wooyeolj/Vision-Based-ADAS/docs/2024년 한이음 ICT멘토링 프로젝트 결과보고서-(일부 내용 편집).pdf

- 1 -

# 2024년 한이음 ICT멘토링

# 프로젝트 결과보고서

프로젝트명 | Development of Vision-Based Intelligent Driving Lane Recognition and Forward Vehicle Collision Avoidance Technology
- 2 -

## 요 약 본

프로젝트 정보

프로젝트명 | 비전 기반 지능형 주행 차선 인식 및 전방 차량 충돌 회피 기술 개발
주제 영역 | □ 생활 □ 업무 ☑ 공공/교통 □ 금융/핀테크 □ 의료 □ 교육 □ 유통/쇼핑 □ 엔터테인먼트
기술 분야 | ☑ SW·AI □ 방송·콘텐츠 □ 블록체인·융합 □ 디바이스 □ 차세대보안 □ 미래통신·전파
달성 성과 | □ 논문게재 및 포스터 발표 □ 앱등록 □ 프로그램등록 □ 특허 □ 기술이전 □ 실용화 □ 공모전( ) ☑ 기타( 프로젝트 완성 )
프로젝트 소개 | 기존 ADAS는 차선이탈 경보, 추돌경보, 교통신호 알람, 보행자 인식 등의 다양한 기능을 여러 센서와 카메라를 이용하여 구현 중이다. 해당 프로젝트에서는 센서를 사용하지 않고, 비전 기반의 여러 영상 처리 기법을 통해, ADAS 기술을 발전시킨다.
개발 배경 및 필요성 | ADAS 기술은 운전자의 안전과 편의성 측면에서 중요한 요소로 부상하고 있다. 날씨 정보를 고려하며, 더욱 지능화된 비전 기반 ADAS 기술은, 운전자의 안전뿐만 아니라 자율주행 기술의 발달, 사회 전반적으로 경제적인 이익을 가져와 줄 것이다.
프로젝트 특·장점 | ・주행차선인식: Canny Edge Detection 알고리즘을 통해 차선을 인식하고 이탈 방지 ・전방객체충돌회피: 전방에 차량, 사람 등이 인식되면 속도를 줄이거나 멈춤 ・도로교통표지판인식: 객체 탐지를 이용해, 교통 표지판을 인식하여 안전 운전
주요 기능 | ・객체검출 : 차량 인식 / 보행자 인식 / 교통 표지판 인식 ・차선인식 : 라인 검출, 허프 변환, 소실점 계산 / 딥러닝 기반 차선 인식 ・거리측정-충돌경고알림 : 객체와의 거리 측정 및 추돌 경고
기대효과 및 활용 분야 | ・더욱 지능화된, 비전 기반 ADAS 기술 기대 ・효율적인 운전으로 인한, 연비 향상 및 운전자 스트레스 감소 ・자동차 운송 산업, 항공, 철도, 선박 등에 활용 및 스마트시티 구현

- 3 -

## (본문) 프로젝트 결과보고서

I. 프로젝트 개요

### 1. 프로젝트 소개

ㅇ 첨단 운전자 보조 시스템 (ADAS)은 자율주행 자동차의 기반이 되는 기술로 운전자가 운전 중에 발생할 수 있는 위험을 센서나 카메라를 통해 감지해 운전자가 대처할 수 있도록 도와주는 안전장치의 일종이다. ㅇ 날씨 변화에 따라 교통사고의 치사율과 빈도가 많은 차이가 일어난다는 것을 고려

해 날씨 정보를 수집 후, 실제로 구현하고자 하는 ADAS 기술에 여러 가지 변수를 추

가해보고자 한다. ㅇ ADAS 기술의 주요 기능으로는 전방 추돌 경고 기능, 차로 이탈 경보, 속도 제한 등

의 여러 가지 기능들이 있는데, 라이다, 초음파 센서 등을 사용하지 않고, 이중 딥러닝

비전 영상 처리를 기반으로, YOLO 객체 인식 등의 기술을 이용하여 전방 객체 및 차

선 인식, 거리 측정 등의 기술을, 수집한 날씨 등의 정보를 고려하여 구현해보려 한다.

### 2. 개발 배경 및 필요성

ㅇ ADAS 기술은 운전자의 안전과 편의성 측면에서 중요한 요소로 부상하고 있다. 통

계상 교통사고로 인해 약 25초에 1명씩 사람이 사망하고 있는데, ADAS 시스템을 통해

운전자를 보조하여 운전자의 집중력을 올려줄 수 있고 그에 따른 부가 효과로 운전자

의 안전뿐만 아니라 자율주행 기술의 발달 및 사회 전반적으로 경제적인 이익을 가져

와 줄 것으로 예상된다. ㅇ 통계적으로 우천, 안개 및 눈 등의 기상 상태에 따라 맑은 날 대비 교통사고의 사

망률 등이 더 높게 나타나는 경향이 있는데, 이를 방지하기 위해 날씨 정보를 고려하

여 ADAS 시스템에서 여러 가지 변수를 추가하는 것이 향후 자율주행 기술에 필요한

기술 및 기능이다.

- 4 -

ㅇ 현재 위치에 따른 날씨 정보를 수집하여 카메라를 통해 입력되는 영상을 날씨 정보

와 함께 고려하며, 이를 통해 운전자가 해당 정보를 바탕으로 운전하여 발생할 수 있

는 여러 상황에 대해 인지하게 되고, 이를 통해 사고 확률을 낮출 수 있게 된다.

### 3. 프로젝트 특·장점

1) 주행 차선 인식
- Canny Edge Detection, Hough Transform을 이용하여 차선을 인식하고, 해당 차선을 이탈하지 않도록 주행을 도움을 준다.
2) 전방 차량 충돌 회피
- 차량 전방에 차량, 사람 등 물체가 인식되면 속도를 줄이거나 멈추어 충돌을 방지한다.
3) 도로 교통 표지판 인식
- 객체 탐지를 이용하여 도로상의 정지, 속도 제한 표지판 등의 교통 표지판을 인식하여 스스로 속도를 조절하거나 정지한다. ㅇ 기존 프로젝트에서는 차선 인식만을 목표로 하였지만, 이 프로젝트에서는 YOLO 객

체 인식을 이용한 객체 탐지 기능을 추가하여, 차선을 따라 주행하며 전방의 물체를

감지하는 등의 더 진보된 형태의 자율주행을 선보인다. ㅇ 기존 자율주행 기술에서, 라이다와 초음파 센서, 라인 트레이서 센서 등을 사용하는

것과 다르게, 오로지 카메라를 통해 들어오는 영상의 비전 기반 정보를 통해, 전방 차

선-객체를 탐지하고, 상황에 맞는 동작을 하여, 자율주행을 수행한다.

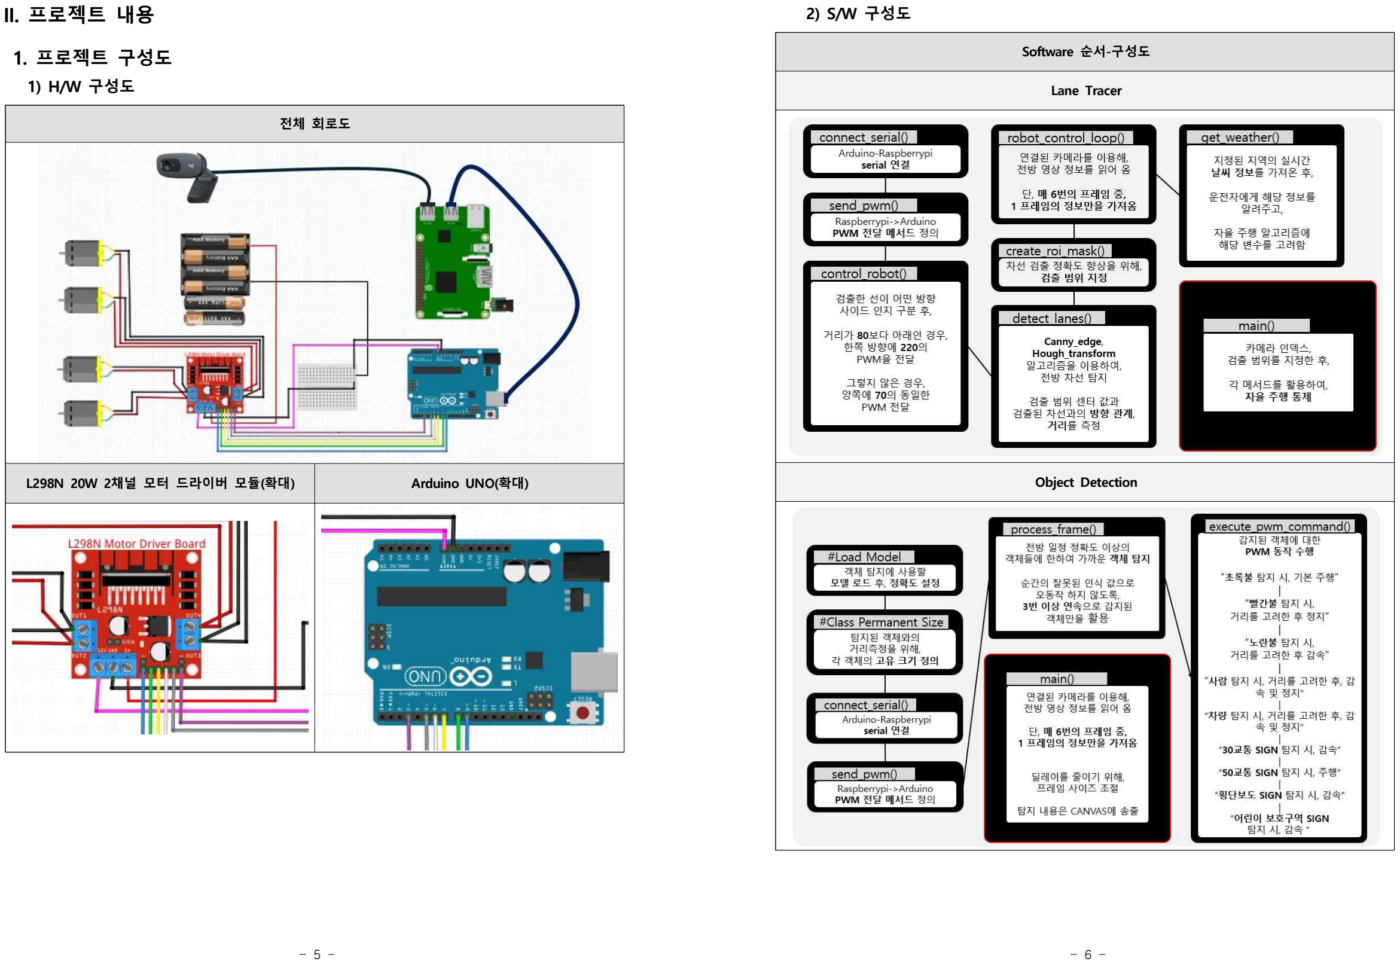
[picture p1: page 3]

- 5 -

II. 프로젝트 내용

### 1. 프로젝트 구성도

1) H/W 구성도

전체 회로도

L298N 20W 2채널 모터 드라이버 모듈(확대) | Arduino UNO(확대)
- 6 -
2) S/W 구성도

Software 순서-구성도

Lane Tracer

Object Detection

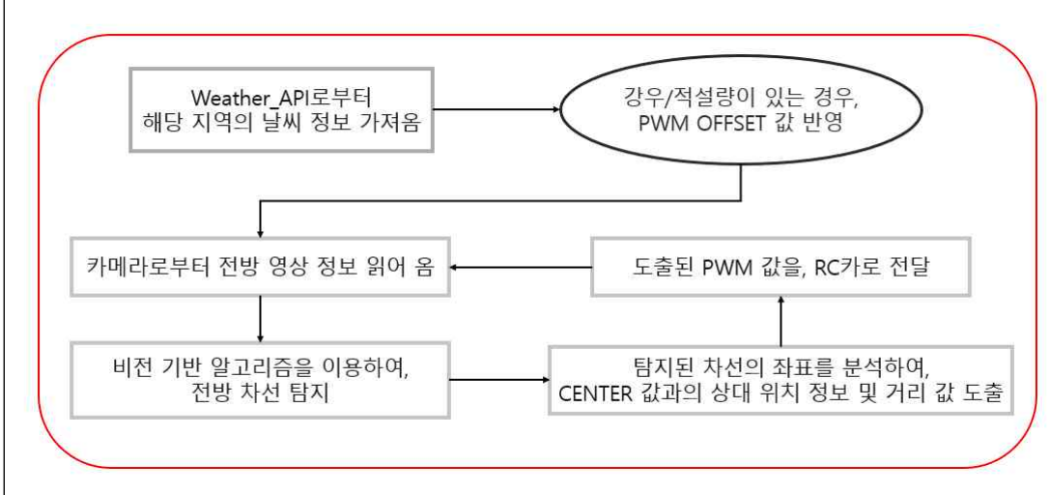
[picture p2: figure]
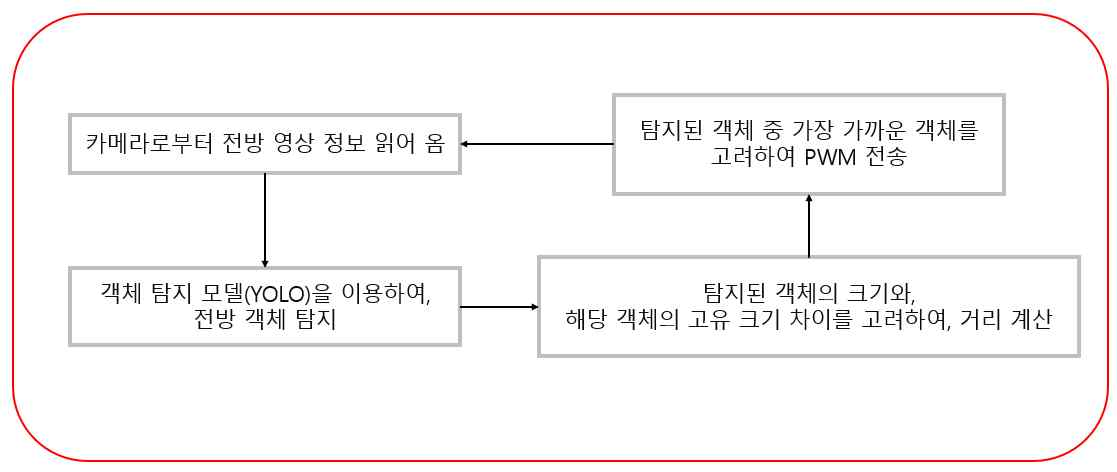
[picture p3: figure]

- 7 -
3) 서비스 흐름도

서비스 흐름도

Lane Tracer

Object Detection

- 8 -

### 2. 프로젝트 기능

1) 전체 기능 목록
구분 | 기능 | 설명
S/W | 영상 처리 | Canny Edge or object Detection, Hough Transform 등 기본적인 영상 처리 이론(차선, 사람, 차, 표지판 등 탐지) -차선: LDWS 알고리즘을 이용한 차선 이탈 방지 -차량: FCWS 알고리즘을 이용한 전방 추돌 방지 -사람: 주행 시 전방 보행자 탐지하여 추돌 방지 -표지판: 속도 표지판, 어린이 보호구역, 보행자 표지판 등 탐지하여, 상황에 맞는 동작 요구

YOLO AI Engine 및
OpenCV 활용
날씨 정보 크롤링 | 해당 지역의 날씨 정보를 실시간으로 받아와서, 운전자에게 안내
H/W 및 S/W | 차선 인식 및 이탈 여부 확인 | 직선 및 곡선 차선 인식 및 차량의 차선이탈 여부 확인. 카메라를 이용한 전방 장애물과의 거리 계산으로, 전방 장애물 발생 시 회피 시나리오 개발 (OpenCV + 카메라기반) 상황 해결

H/W

RC카 2채널 PWM 제어 | Raspberry Pi에서 주는 PWM을 Arduino에서 처리하여, RC카를 알맞게 움직이도록 제어
Raspberry Pi 발열 제어 | 기존 15분 정도밖에 버티지 못하던 Raspberry Pi의 기능 가능 시간을, FAN을 추가하여 수명 연장
전방 영상 정보 읽기 | 카메라를 활용하여, 전방의 영상 소스를 Raspberry Pi로 전달

- 9 -
2) S/W 주요 기능
기능 | 설명 | 프로젝트 실물 사진

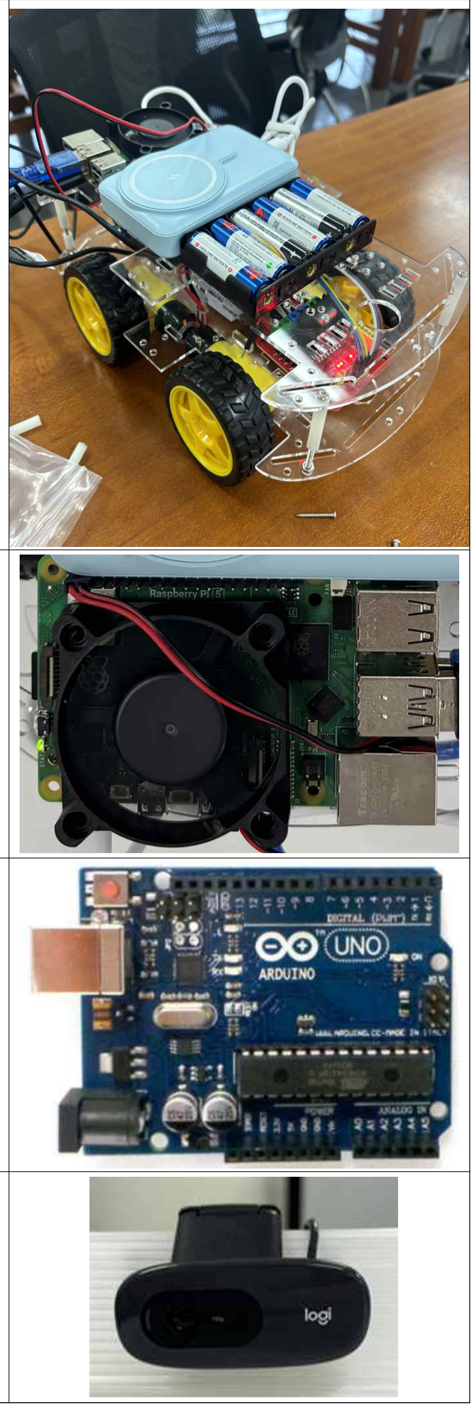
[picture p4: figure]
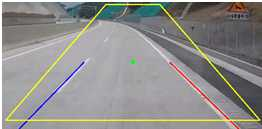
[picture p5: figure]

차선 인식 알고리즘

Canny Edge detection,
Hough Transform을 이용하여
전방 차선을 감지. 차선과 주행 방향의 차이를 탐지하는

알고리즘을 이용해 차선을 따라 주행

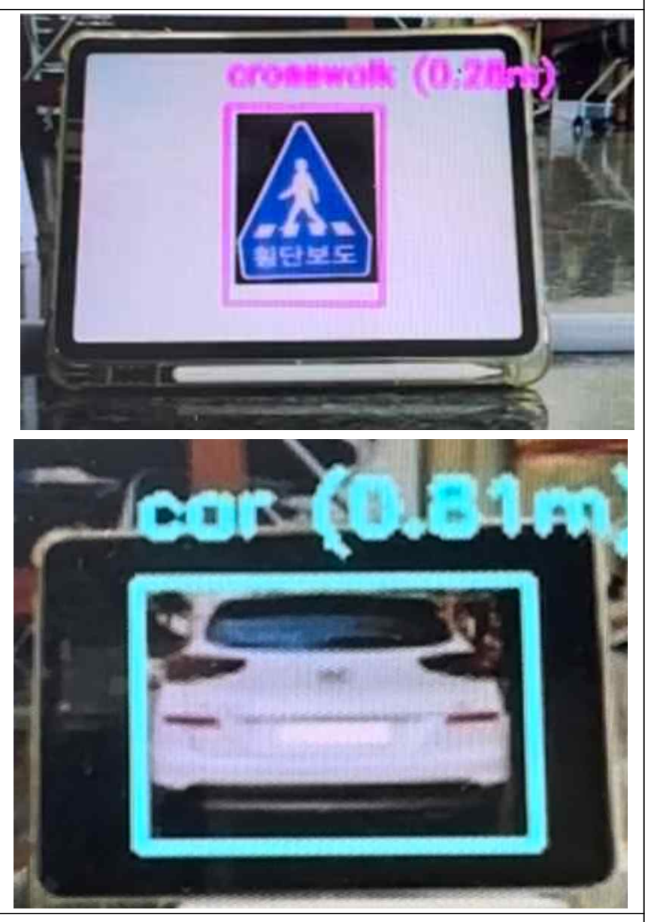
[picture p6: figure]

객체 탐지 및
거리 측정 알고리즘

YOLOv5 Engine을 이용하여 차량과
사람, 표지판, 신호등을 탐지하고, 각 객체의 고유 특성을 고려하여

거리 측정 후 RC카 PWM 제어

ex. 신호등을 탐지한 경우, 빨간불을 인식할 시, 정지하고, 초록불을 인식 시에 주행

표지판을 탐지하는 경우에는, 속도 표지판, 혹은 동작 표지판 등을

구별하여 그에 맞는 동작을 수행
(*오른쪽 상단 사진은, 사람을 인식한
후에, 해당 객체까지의 거리를 측정한
모습)

날씨 정보 크롤링

날씨 정보 웹사이트로부터
실시간으로 정보를 받아, 해당 지역의 날씨를 분석하여, 운전자에게 알맞은 조언을 수행
- 10 -
3) H/W 주요 기능
기능/부품 | 설명 | 프로젝트 실물 사진
RC카 본체 | Arduino에서 전송하는
| PWM으로 바퀴(모터) 동작

Raspberry Pi5 + FAN

카메라로부터 실시간
영상 정보를 받아, 차선 탐지 분석, 객체 탐지 분석 후, 알맞은 PWM을 Arduino로 전송

+
Raspberry Pi 발열로 인한, 성능 저하를 방지하기 위해, 3V FAN 추가 설치

Arduino UNO

바퀴(모터)로 전송할 수 있는
PWM을 사전에 정의

Raspberry Pi로부터 받은 PWM을
미리 배정한 핀으로 전송

Logitech C270 실시간 전방 영상 정보를 받아, Raspberry Pi로 전송

- 11 -

### 3. 주요 적용 기술

기술 | 설명 | 기술 사진

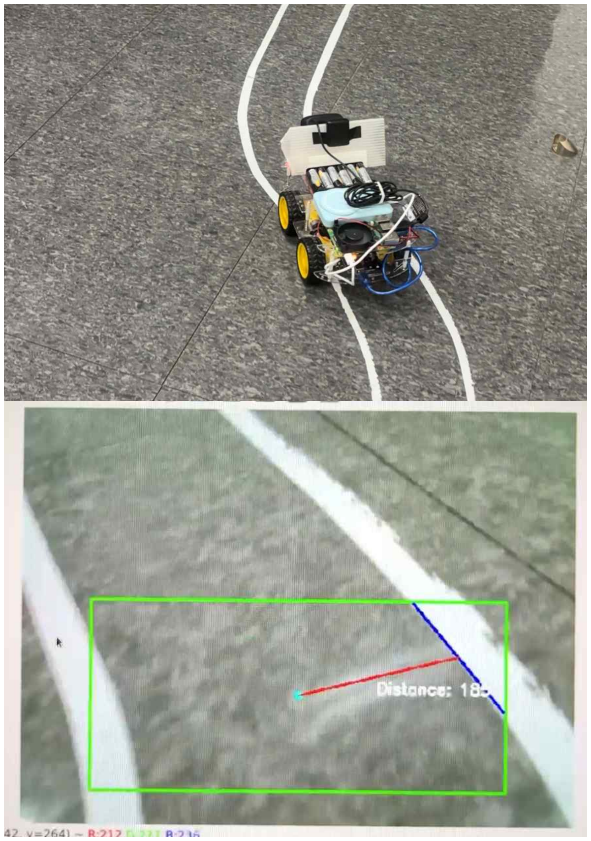
[picture p7: figure]

차선 검출 및

차선이탈 방지

(영상 전처리)

-RoI(Region of Interest) 마스크 생성
- 특정 관심 영역만 처리하기 위함

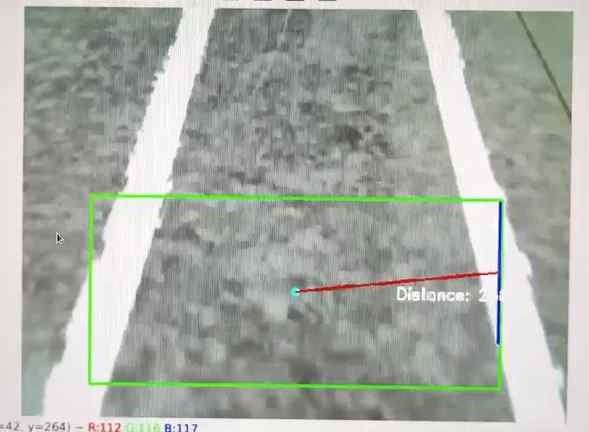
[picture p8: figure]

-HSV 색상 공간 변환
- 조명 변화에 상대적으로 민감한
RGB 대신, HSV 색상 공간을 적용

-이진화: 흰색과 노란색 마스크 생성
- HSV 범위가 다른 두 색상 차선을 각각 검 출하고, 비트 OR 연산으로 결합하여, 모든
차선 색상을 포함하는 마스크 생성

-가우시안 블러(Gaussian Blur): 노이즈 제거
- 검출된 마스크에 가우시안 블러를
적용하여 작은 노이즈를 제거

-Canny Edge Detection: 경계선 검출
- 블러링 된 이미지에서, Canny 알고리즘을 이용해 경계선을 검출

-Hough Transform: 직선 검출
- 허프 변한으로 에지 사이의
연속된 직선 검출

-중심점과 직선과의 거리측정 후, PWM 제어
- 중심점의 X좌표와, 검출된 직선의 X좌표를
비교하여, 어느 방향의 직선이 검출되었는
지 확인. +

해당 방향 직선과의 픽셀 거리를 측정하여
거리가 가깝다면, 방향 제어 PWM 전송
전방 객체 탐지 및 충돌 방지 | YOLO 객체 탐지 엔진을 기반으로, ‘0_파란불’, ‘1_빨간불’, ‘2_노란불’, ‘3_사람’, ‘4_자동차’, ‘5_30 Sign’, ‘6_50 Sign’, ‘7_Crosswalk Sign’, ‘8_Childrenzone Sign’탐지 +각 객체의 고유 크기를 고려하여, 객체와 RC카 사이의 거리 측정 후, PWM 제어
- 12 -

Weather API를
이용한
실시간 날씨
데이터 활용

기상 예보 사이트에서 실시간으로
날씨 정보를 받아와, 비나 눈이 오는 경우, PWM 값을 보정

### 4. 프로젝트 개발 환경

구분 | 상세내용
S/W 개발환경 | OS | Linux(Raspbian), Window
| 개발환경(IDE) | PyCharm, VS(Visual Studio), IDLE(Python)
| 개발도구 | Raspberry Pi5, Arduino UNO
| 개발언어 | Python, C
| 기타사항 | X
H/W 구성장비 | 디바이스 | Raspberry Pi5, Arduino UNO, Logitech C270
| 센서 | X
| 통신 | UART Serial Communication
| 언어 | Python, C
| 기타사항 | RC Car Kit
프로젝트 관리환경 | 형상관리 | 자택 보관, 학교 실습실 보관
| 의사소통관리 | 메신저(Discord)를 통한 온라인 미팅, 매주 오프라인 개발 진행
| 기타사항 | 매달 멘토-멘티 간 온라인 미팅

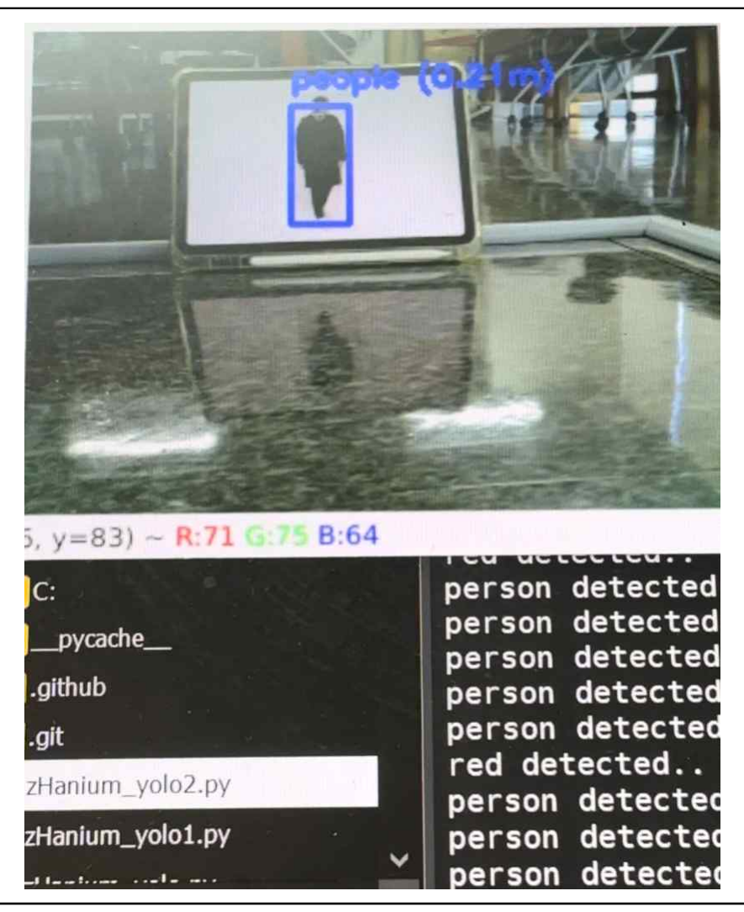
[picture p9: figure]

- 13 -

### 5. 장비(기자재/재료) 활용

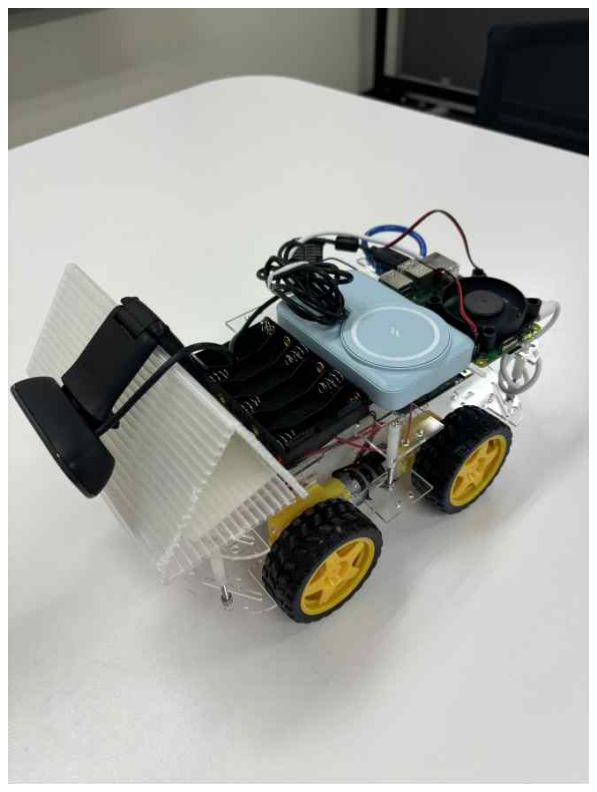
[picture p10: figure]
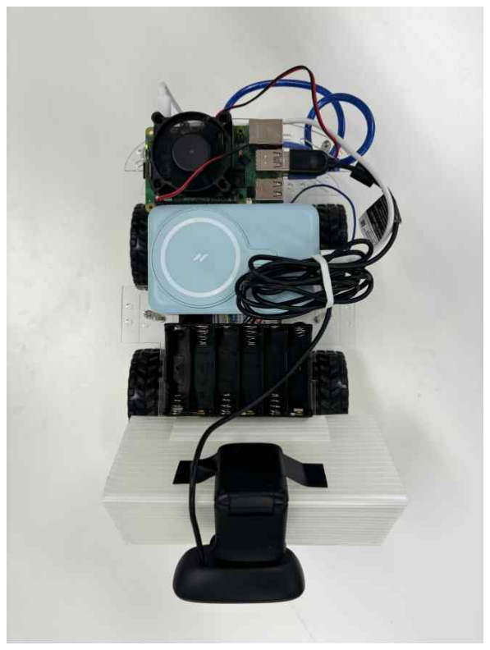
[picture p11: figure]
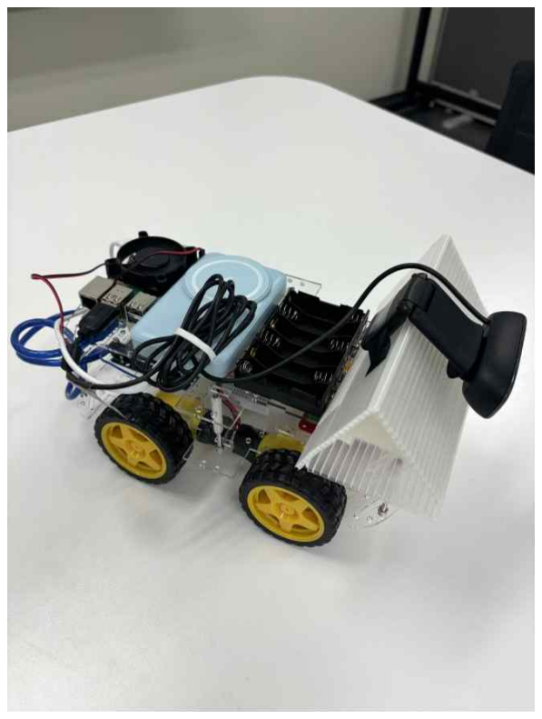
[picture p12: figure]

번호 | 품명 | 작품에서의 주요기능
1 | Raspberry Pi5 | - 영상 데이터 처리 및 분석, 모터 제어, 외부 통신 등의 제어 허브
2 Arduino UNO | | - 모터 구동을 위한, PWM 신호을 받아 차량을 제어하는 하드웨어 인터페이스
3 | Logitech C270 | - 프레임 단위로 실시간 영상을 수집하여, 영상 처리 알고리즘에 입력
4 | Cooling Fan | - Raspberry Pi 성능 향상을 목적으로 부착
5 | 6량 건전지 | - RC Car에 동력 공급
6 | 보조 배터리 | - Raspberry Pi에 전력 공급
7 | PVC 골판지 | - 카메라 높이 조절을 위해 설치
8 | 흰색 테이프 | - 도로 차선 구현

### 6. 프로젝트 작동 동영상

[1] 2024 한이음 비전 기반 지능형 주행 차선 인식 및 전방 차량 충돌 회피 기술 개발 (Line Detection)

>“https://www.youtube.com/watch?v=Ap_QmALgXLc”

[2] 2024 한이음 비전 기반 지능형 주행 차선 인식 및 전방 차량 충돌 회피 기술 개발 (Object Detection)

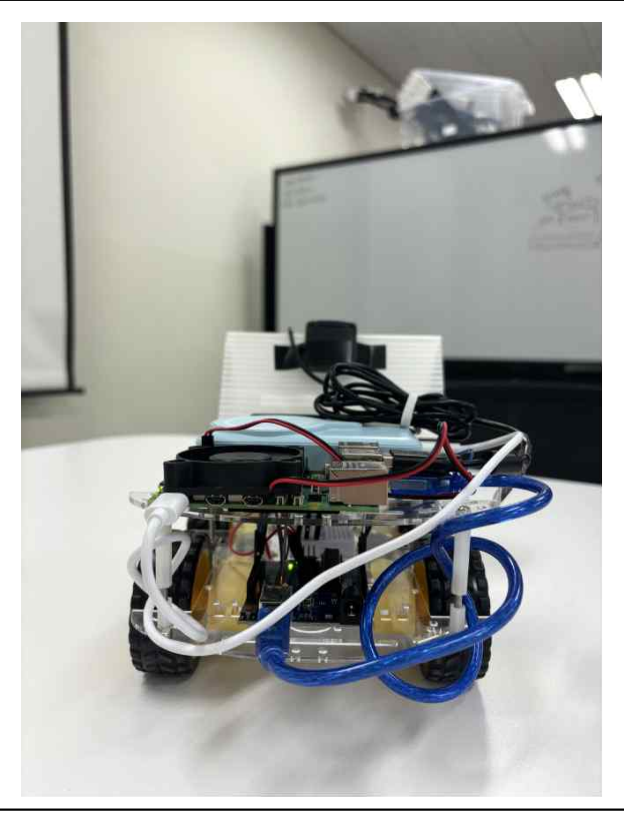
[picture p13: figure]
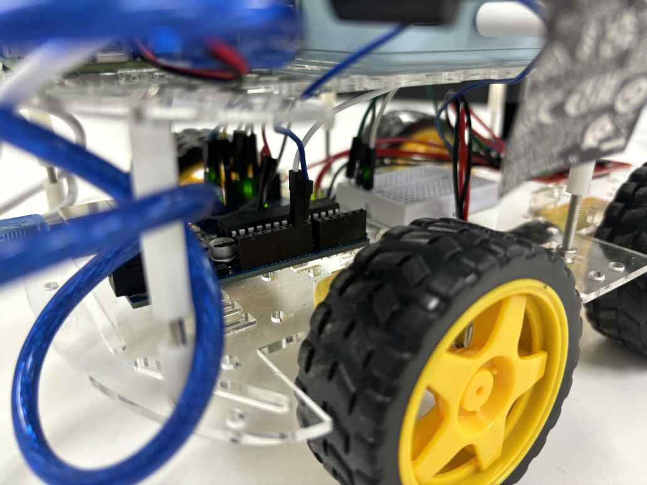
[picture p14: figure]
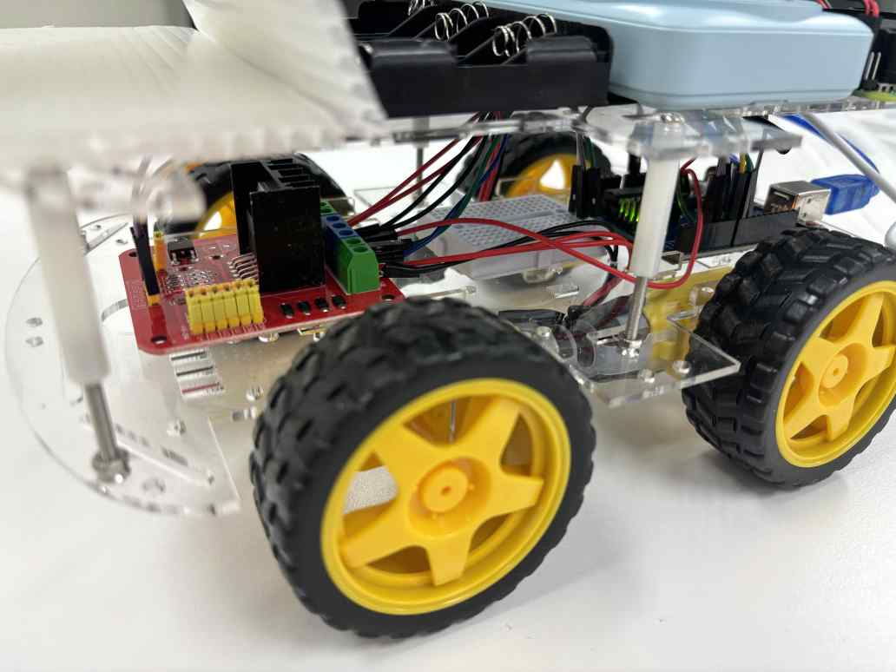
[picture p15: figure]

>“https://www.youtube.com/watch?v=2-qXVjHOrG8”

- 14 -

### 7. 결과물 상세 이미지

Left Front View | Top View | Right Front View

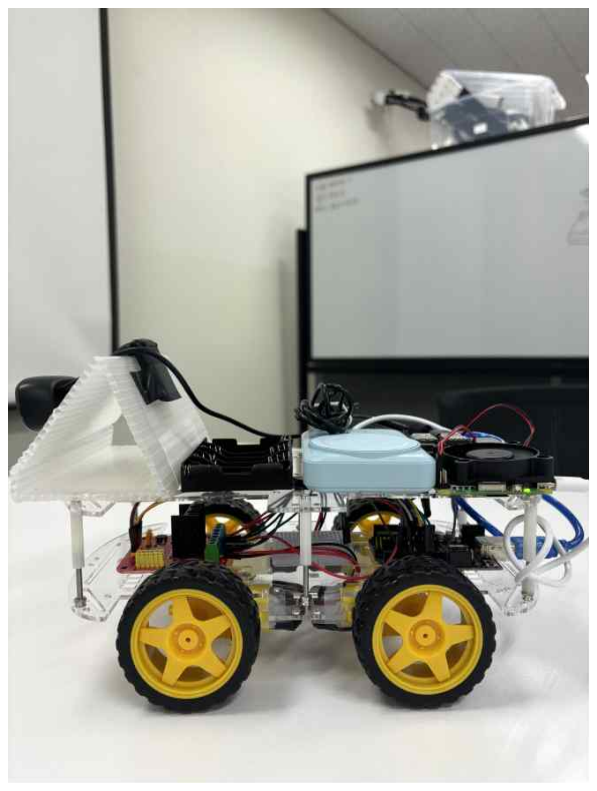
[picture p16: figure]
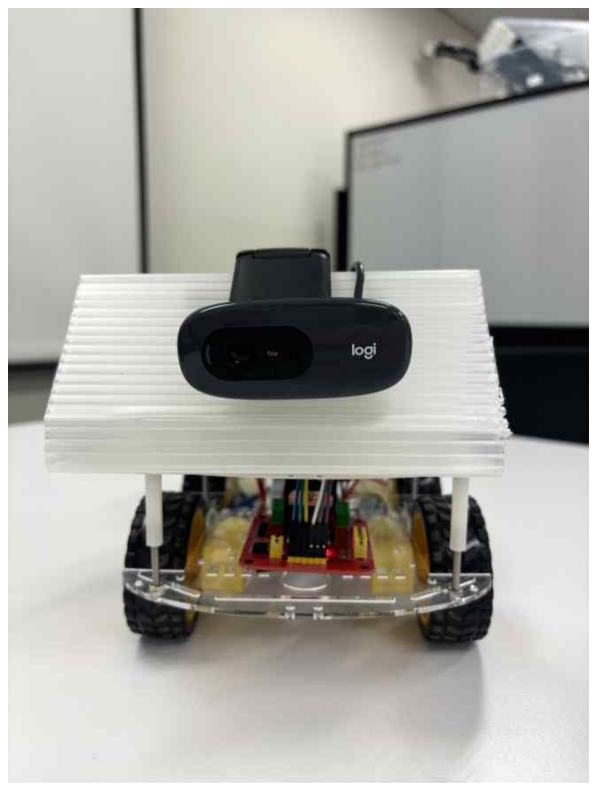
[picture p17: figure]
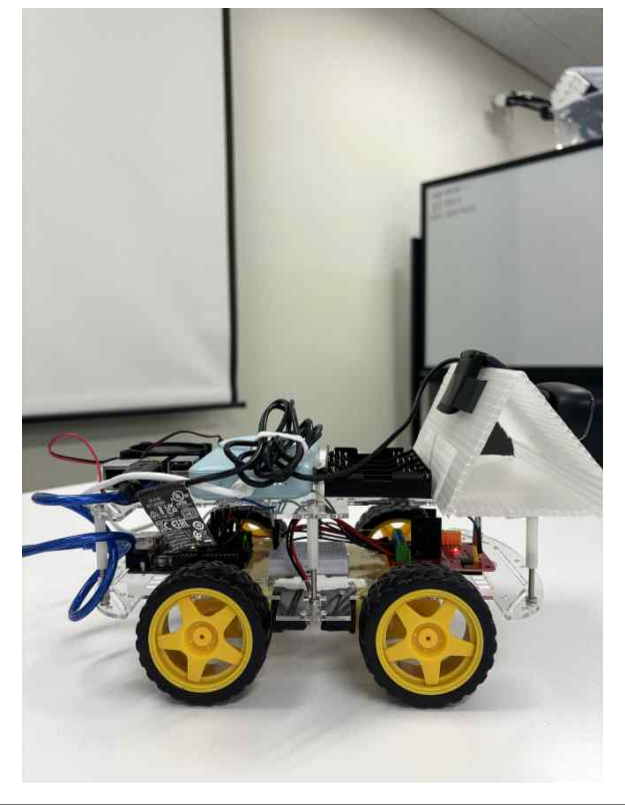
[picture p18: figure]

Left View | Front View | Right View
Inside 1 | Rear View | Inside 2

- 15 -

III. 프로젝트 수행 내용

1. 프로젝트 수행 일정 구분 | 추진내용 | 수행일정
3월 | 4월 | 5월 | 6월 | 7월 | 8월 | 9월 | 10월 | 11월
계획 | 프로젝트 수행 계획
분석 | Canny Edge Detection 및 Hough Transform 알고리즘 분석
| LDWS 이론 분석 및 카메라를 이용한 거리 계산 방식 분석
설계 | LDWS 이론 설계 및 YOLO 객체 인식 모델 설계
| LDWS 성능 향상을 위한 세부 설계 및 카메라를 이용한 거리 계산 설계
개발 | 예상 시나리오 구체화 및 LDWS 알고리즘 개발(OpenCV 영상처리)
| RC카 Kit 조립 및 YOLO 모델 개발 +카메라를 이용한 거리 계산 알고리즘 개발
| Croling API 알고리즘 개발 +메인 코드 개발 및 라즈베리 포팅
| 시나리오를 기반으로 하는 모의 주행 테스트 +성능 디버깅
테스트 | 실제 주행 테스트
종료 | 작품 보완
온·오프라인 미팅 | 프로젝트 진행도 점검 및 질의응답
- 16 -

### 2. 프로젝트 추진 과정에서의 문제점 및 해결방안

1) 프로젝트 관리 측면
[1] 우리 팀은 매달 멘토님과 온라인 미팅을 진행하고, 일주일에 최소 한번은 학교나, 학교 앞 카페에서 만나 오프라인으로 개발을 진행하였다. 다만, 각자의 일정이 모두 상이하여, 매주 같은 날-시간에 만나지는 못하였고, 서로의 일정을 고려함에 따라, 매번 다른 날에 만나거나, 팀원 모두가 다 같이

만나지 못하는 경우가 여러 번 생겼었다.

때문에, 직전 주에 그다음 주 일정을 미리 계획하고, 해야 할 일을 정리하여, 역할을 분배해, 온라인으로도 여러 번 미팅하는 등의 방법을 마련하여,

초기 프로젝트를 진행할 때 비해, 안정적으로 진행할 수 있었다. 무엇보다 역할을 분배할 때는, 특정 작업을 선호하는 팀원에게 그 역할을

미리 배정함으로써, 작업 효율을 높일 수 있었다.

- 17 -
2) 프로젝트 개발 측면
[1] 초기 프로젝트 목표는, RC카가 차선 탐지와 객체 탐지를 동시에 수행하도록 하는 것이었다. 하지만, 차선 탐지 알고리즘과 객체 탐지 알고리즘은 생각보다 매우 복잡하였고, 둘 중 하나의 기능조차 RC카가 수행하는 데 있어서 매우 버거웠다.

이를 해결하기 위해, 차선 탐지와 객체 탐지라는 두 개의 큰 목표를 분리해서 개발하기로 하였고, 실시간 영상 정보도 매 몇 FRAME을 건너뛰는 식의 방법으로 카메라(Raspberry Pi)의 부담을 최대한 줄여보았다.

[2] RC카 양쪽 모터로 향하는 핀에, 상황에 맞는 PWM을 주더라도, 모터 문제 및 구조적 문제(바퀴가 두 개뿐)를 이유로, RC카가 해당 PWM에 맞게 주행하지 않는 것은, 이번 프로젝트의 가장 큰 문제였다. Software 쪽에서 정확한 차선 탐지를 하여 PWM을 전송하더라도, 모터가 그 신호를 제대로 받지 못하면, 차량이 잘못된 방향으로 주행했기 때문이다.

결국, 많은 노력에도 불구하고, Software쪽 에서 이를 해결하기에는 불가능하다는 결론을 내려, 초기 바퀴가 2개인 RC카를 버리고,
바퀴가 4개인 RC카와 새로운 모터를 만듦으로써, 주행 안정성을 높일 수 있었다.
[3] Arduino용 RC카 특성상, 바퀴의 방향을 조절할 수 없고, 바퀴가 굴러가는 힘만 조절 가능하다는 점은, RC카의 주행 방향을 바꾸는 데 큰 어려움을 주었다. 일반적인 차량이 방향을 바꾸는 방법인, 바퀴의 방향을 조절할 수 없었기에 다른 방법을 마련해야 했다.

이는 RC카의 주행 방향을 바꿔야 하는 경우, 양 바퀴에 극단적으로 큰 차이의 PWM을 전송함으로써, 차량이 드리프트 하듯이 주행 방향을 바꾸도록 할 수 있었다.

- 18 -
4. 프로젝트를 통해 배우거나 느낀 점 - 이번 프로젝트에서는 현재 4차 산업혁명의 주축이 된 인공지능에 대하여 이해하고, 이 기술을 응용한 자율주행을 구현해보았다. 인공지능은 거의 모든 분야에 있어서 영

향을 끼치는, 미래를 위하여 반드시 준비해야 할 중요한 기술로 떠오르고 있으며, 자율 주행 기술 또한 수많은 기업과 나라에서 지원을 아끼지 않을 만큼 중요한 기술이다. 우리 팀은 이러한 시대 흐름에 따라, 이번 프로젝트에 지원하였다. 진행 과정에서

Canny Edge Detection, Hough Transform과 같은 다양한 기법을 익히고 응용해 보았 으며, Canny Edge Detection에서 경계를 인식하기 위하여 이미지를 처리하는 방법, Hough Transform이 쓰이는 이유와 경계를 인식하기 위해 이미지에서 선형 특징을 추

출하는 방법을 배우게 되었다. 이 기법들은 자율주행의 핵심 요소인 도로와 차선을 인 식하는 데 매우 유용하게 사용되었다. 특히, Canny Edge Detection은 이미지에서 노이즈를 제거하고 유의미한 경계를 강조

하는 데 탁월한 성능을 보였으며, Hough Transform은 이러한 경계를 직선이나 곡선으 로 변환하여 도로와 차선의 위치를 파악하는 데 중요한 역할을 하였다. 또한, 우리는 딥러닝을 활용한 객체 인식 기술도 프로젝트에 적용하였다. 이를 통해

자율주행 차량이 보행자, 다른 차량, 신호등 등 다양한 객체를 인식하고 반응할 수 있 도록 하였다. 프로젝트를 진행하면서 팀워크의 중요성도 크게 느낄 수 있었다. 자율주행 기술은 매

우 복잡하고 다양한 전문 지식과 기술이 요구된다. 따라서 팀원들 각자가 자신이 잘하 는 분야에서 최선을 다하며 협력하는 과정을 가졌고, 여기서 많은 것을 배우고 성장할 수 있었다고 생각한다. 문제를 해결하기 위해 서로의 의견을 존중하고 적극적으로 소 통하는 과정이, 프로젝트의 성공에 큰 기여를 할 수 있었다고 생각한다. 더불어, 데이터 수집 및 전처리의 중요성도 실감했다. 자율주행 시스템은 대량의 데이

터를 필요로 하며, 이러한 데이터가 얼마나 정제되고 정확하게 준비되었는지가 시스템 의 성능에 큰 영향을 미친다. 실제 도로 환경에서 수집한 데이터를 통해 모델을 학습 시키고 평가하는 과정에서, 데이터의 품질이 성능 향상에 얼마나 중요한지 알게 되었 다. 마지막으로, 이번 프로젝트를 통해 지속적인 학습의 필요성을 느낄 수 있었다. 인공지

능과 자율주행 기술은 빠르게 발전하고 있으며, 최신 기술 동향을 파악하고 이를 프로 젝트에 적용하는 것이 매우 중요하다. 앞으로도 끊임없이 학습하고 새로운 기술을 습 득하여 변화하는 시대에 발맞추어 나가야겠다는 다짐을 하게 되었다. 종합적으로, 이번 프로젝트는 인공지능과 자율주행 기술에 대한 깊이 있는 이해를 제

공했을 뿐만 아니라, 실질적인 경험을 통해 팀워크와 문제 해결 능력을 향상시킬 수 있는 귀중한 기회였다. 이러한 경험들은 앞으로의 학업과 커리어에 큰 도움이 될 것이 라 확신한다.

- 19 -

### Ⅳ. 기대효과 및 활용 분야

### 1. 프로젝트의 기대효과 ㅇ 기존 대중적인 ADAS와 달리, 센서 등을 사용하지 않고, 비전 기반 영상 소스만을

사용하는 함에 있어, 경제성 확보
ㅇ 객체 검출 및 차선 인식을 통해 운전자에게 실시간 경고를 제공하여, 사고 예방에 기여
ㅇ 전방 추돌 경고 알림 시스템은 위험 상황을 사전에 감지하여, 운전자의 대응 시간 을 확보
ㅇ 차선이탈 경보 장치는 차량 충돌 사고의 주요 원인인 차선 이탈상황을 감지하여, 사고 위험 감소

ㅇ 속도 제한 및 정지 신호와 같은 교통 표지판을 준수하여, 운전자 간의 충돌 회피 및 성숙한 운전문화 형성
ㅇ 실시간으로 제공되는 교통 정보와 날씨 예보는 운전자에게 편의성을 제공
ㅇ ADAS의 기능 향상은 운전자들의 스트레스를 감소시키고 운전에보다 집중할 수 있

도록 도움

ㅇ 운전 중 제공되는 정보들과 서비스는 연비 향상과 연결되어, 자동차의 연료 소비를

감소시키고 환경보호에 도움이 됨

ㅇ 효율적인 주행으로 인한 연료 소비 감소는 대기 오염과 탄소 배출을 줄여 지속

가능한 도로 환경을 조성

### 2. 프로젝트의 활용 분야 ㅇ 자율주행과 마찬가지로 다양한 이미지를 다루는 항공, 철도, 선박 분야

ㅇ 자율주행을 통한 자동화 운송 산업
ㅇ 교통통제와 교통사고가 없는 스마트시티 구현

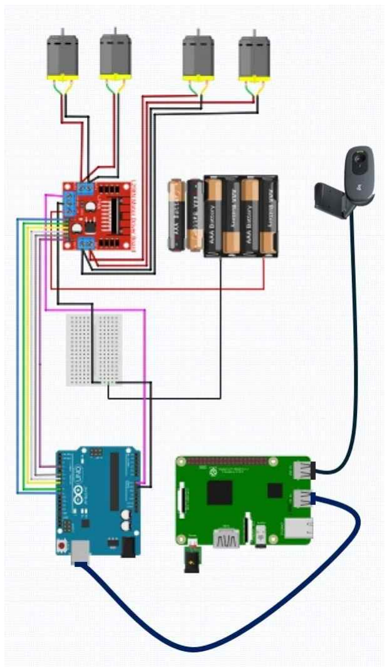
[picture p19: figure]

- 20 -

Ⅴ. 참고자료

□ 붙임파일 ○ 회로도
