wooyeolj/Vision-Based-ADAS/(commit log)

2025-12-02 Create 최종 보고서의 일부 및 이미지 추가 계획
2025-12-02 Create 유튜브 영상 두개 추가예정
2025-12-10 Add files via upload
    결과보고서 편집본 업로드 (일부 내용 수정 )
2025-12-10 Rename 2024년 한이음 ICT멘토링 프로젝트 결과보고서.pdf to 2024년 한이음 ICT멘토링 프로젝트 결과보고서-(원본과 일부 내용 상이).pdf
